itzcarmennn/X-UniTech/others/Supporting Details for Selected Topics/images/image23.png

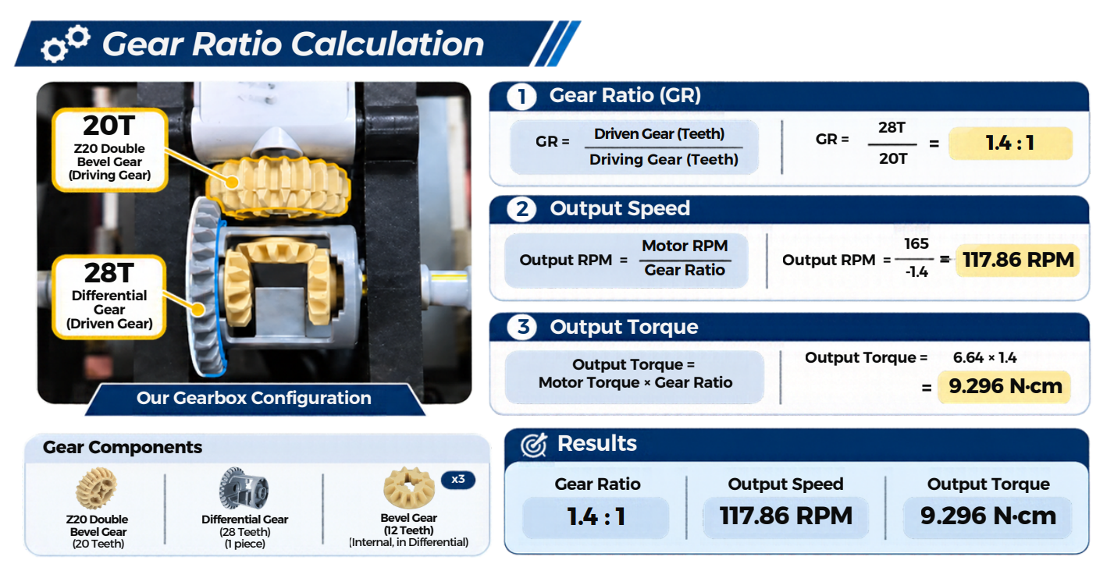
others/Supporting Details for Selected Topics/images/image23.png
