itzcarmennn/X-UniTech/v-photos/C. Third Generation/Left View.png

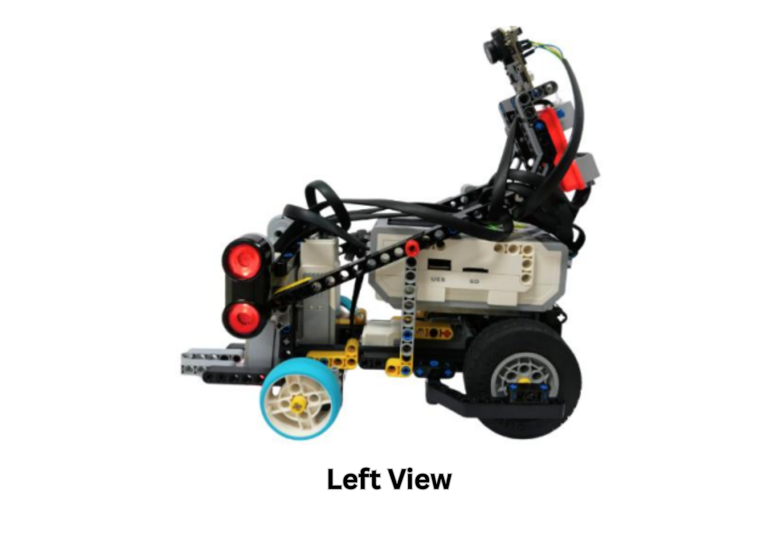
v-photos/C. Third Generation/Left View.png
