itzcarmennn/X-UniTech/README.md

# X-UniTech Team, Malaysia

Welcome to X-UniTech Team Malaysia! 

This repository showcases our final robot design, developed to complete both the **Open Challenge** and **Obstacle Challenge**. For an overview of our development journey from **Generation 1 to Generation 4**, please refer to the [**Robot Development & Iteration Cycle**](https://github.com/itzcarmennn/X-UniTech/blob/4292ab41017db0be74e6131bf3cbaa6cbdb87c5d/others/Robot%20Development%20%26%20Iteration%20Cycle.pdf). For detailed information about our robot's design, engineering decisions, calculations, and testing results, please refer to our **[Engineering Journal](PASTE_YOUR_ENGINEERING_JOURNAL_LINK_HERE)**.

# Table of Contents

# Summary Video
This 6-minute video provides a brief overview of our project and its documentation. We encourage you to watch it for a quick and clear understanding of our work!

# Team Members
We are X-UniTech, a team of two teacher trainees from Malaysia, made up of **Raymond Ting Yih Wei**, the brain behind the code, and **Carmen Heng Jia Min**, the hands behind the robot. Together, we turn ideas into robots!

<p align="center">
Team Photo (Version 2)
</p>

# Robot Overview

<p align="center">

</p>

<table>
  <tr>
    <td align="center"><strong>Top View</strong><br>Top View</td>
    <td align="center"><strong>Front View</strong><br>Front View</td>
    <td align="center"><strong>Left View</strong><br>Left View</td>
  </tr>
  <tr>
    <td align="center"><strong>Bottom View</strong><br>Bottom View</td>
    <td align="center"><strong>Back View</strong><br>Back View</td>
    <td align="center"><strong>Right View</strong><br>Right View</td>
  </tr>
</table>

# Performance Video 

<table>
  <tr>
    <td align="center" width="50%">
      <strong>Open Challenge</strong><br><br>
      Open Challenge<br><br>
      <a href="https://youtu.be/6Eh0cw0jpJg"><strong>▶ Watch Open Challenge Video</strong></a>
    </td>
    <td align="center" width="50%">
      <strong>Obstacle Challenge</strong><br><br>
      Obstacle Challenge<br><br>
      <a href="https://youtu.be/F9Ot-lOl4QI"><strong>▶ Watch Obstacle Challenge Video</strong></a>
    </td>
  </tr>
</table>

If you are interested, explore the previous robot generations (Generation 1–3) in the [**V-Photos Folder**](https://github.com/itzcarmennn/X-UniTech/tree/59bc95add0fecbfca5860f1d18f3c837b4af057b/v-photos).

# 1.0 Mobility and Mechanical Design

## 1.1 Mechanical Structure
<p align="center">
  Robot Photo (Fourth Generation)
</p>

**Robot Dimensions:** Our robot dimensions (**250 mm × 120 mm × 295 mm**) were selected to maximize camera height while maintaining a compact and mechanically stable structure that accommodates all components. 

**Robot Building Process:** Follow our step-by-step building tutorial to learn how to assemble the robot in the [Video Building Process](https://youtu.be/vY-6_uyMKQI?si=AjLbu2vJUjDL66he).

**Robot Chassis:** We initially used a LEGO-built chassis in Generation 1-3 but later switched to a custom 3D-printed chassis to reduce the complexity of multiple LEGO connections and create a more compact, stable structure.

<table>
  <tr>
    <td align="center" width="50%">
      <strong>Previous LEGO Chassis</strong>
    </td>
    <td align="center" width="50%">
      <strong>Recent 3D-Printed Chassis</strong>
    </td>
  </tr>
  <tr>
    <td align="center">
      Previous LEGO Chassis
    </td>
    <td align="center">
      Recent 3D-Printed Chassis
    </td>
  </tr>
</table>

[Click for Robot Chassis CAD and Camera Mounting in STL File](https://github.com/itzcarmennn/X-UniTech/tree/59bc95add0fecbfca5860f1d18f3c837b4af057b/models/Materials%20of%20Computer-Aided%20Design%20(CAD)%20%5BFourth%20Generati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)

**Motor:** We selected the **EV3 Medium Motor (45503)** for its higher rotational speed and compact size. During the Open Challenge, the drive motor operates at 100% speed. During the Obstacle Challenge, the drive motor operates at 65% speed, while the steering motor operates at 70% speed to maintain stability and ensure reliable obstacle navigation. [**Purchase Link**](https://www.brickowl.com/catalog/lego-mindstorms-ev3-medium-motor-99455)

<p align="center">

</p>

## 1.2 Drive System

<table>
  <tr>
    <td width="30%" align="center" valign="middle">
      Gearbox Configuration
    </td>
    <td width="70%" align="justify" valign="middle">
      We selected the <strong>EV3 Medium Servo Motor (45503)</strong> with a 20T driving gear and 28T differential-driven gear, achieving a 1.4:1 gear reduction ratio. The wheel assembly uses <strong>LEGO Parts 32019</strong> and <strong>86652</strong> to complete the drive mechanism. This configuration reduces the output speed while increasing the available torque to support robot movement.
      <br><br>
      Here's how we calculate it:
    </td>
  </tr>
</table>

<p align="center">

</p>

This combination also provides an ideal force and thrust-to-weight ratio. Here’s how we calculate it. 

<p align="center">

</p>

[Click for detailed information on Drive System Choice](https://drive.google.com/file/d/1EcJO7IQbdKK3gPobmQDVCEyetCO6iOfM/view?usp=sharing)

## 1.3 Steering System

<p align="center">
Steering Structure
</p>

Our steering system combines a **LEGO Pin Crank (33299)**, which serves as the transmission component, with custom-designed 3D-printed parts. LEGO axles and connectors are used to connect the components and complete the steering mechanism.

[Here’s more about Steering Component CADs in STL File](https://github.com/itzcarmennn/X-UniTech/tree/59bc95add0fecbfca5860f1d18f3c837b4af057b/models/Materials%20of%20Computer-Aided%20Design%20(CAD)%20%5BFourth%20Generati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)

<p align="center">

</p>

**Ackermann Steering:** We chose Ackermann steering because it allows the inner wheel to turn more than the outer wheel, resulting in smoother turns. The following calculation shows the outer wheel angle when the inner wheel angle is 35° during a left turn.

<p align="center">

</p>

**Iterations & Trade-off:** In Generation 2, we tested a **gear-reduced steering system** but found it responded more slowly than direct steering. Therefore, we decided to retain the **direct steering** mechanism for more responsive turning. 

<p align="center">
Iterations Trade-off
</p>

**Steering System Trade-off**
<p align="center">

</p>

• The Ackermann steering system was selected because it provides better turning performance, reduces tyre scrubbing and improves manoeuvrability. 
<p align="center">

</p>

[Click for detailed information on Steering System Choice](https://drive.google.com/file/d/1WwsIxELfLkICFE4XAowNIsLzPJPw8FXX/view?usp=sharing)

# 2.0 Power and Sensor Architecture

**Power System Layout:** A 9V battery supply powers the **EV3 Intelligent Brick** as the **“brain”** of our robot, which manages two motors and four sensor connections, including two Ultrasonic Sensors through the MUX.
<p align="center">
Power System Layout
</p>

## 2.1 Power Budget

The maximum current value is used, while both EV3 Medium Motors are calculated using their stalled current of 800 mA each. 
<p align="center">

</p>

The total power consumption is: 0.015 + 0.075 + 0.200 + 0.175 + 14.400 + 0.700 = <strong><ins>15.565 W</ins></strong>.  
Here’s how to calculate the Battery Runtime Calculation for Max Load (15.565W):

<div align="center">

<table>
  <tr>
    <td width="50%" align="center" valign="middle">
      <table>
        <tr style="background-color: #DCEAF7;">
          <th align="center">Battery Parameter</th>
          <th align="center">Value</th>
        </tr>
        <tr>
          <td align="center"><strong>Nominal Voltage</strong></td>
          <td align="center">9V</td>
        </tr>
        <tr>
          <td align="center"><strong>Battery Capacity</strong></td>
          <td align="center">2333mAh</td>
        </tr>
        <tr>
          <td align="center"><strong>Total Energy</strong></td>
          <td align="center">21Wh</td>
        </tr>
      </table>
    </td>
    <td width="50%" align="center" valign="middle">
      Battery Runtime Calculation
    </td>
  </tr>
</table>

</div>
