itzcarmennn/X-UniTech/schemes/ObstacleChallenge_SchematicDiagram.pdf

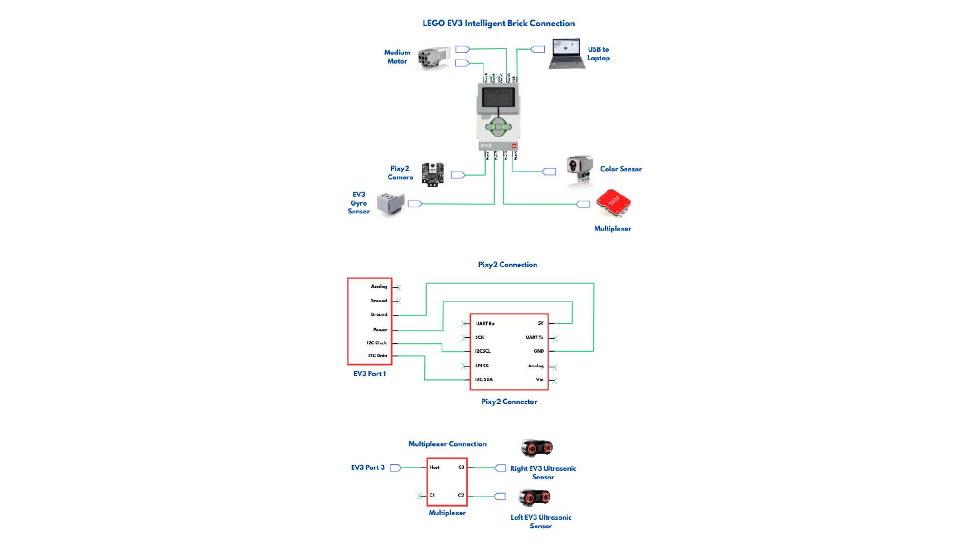
[picture p149: page 1]
