itzcarmennn/X-UniTech/schemes/OpenChallenge_SchematicDiagram.pdf

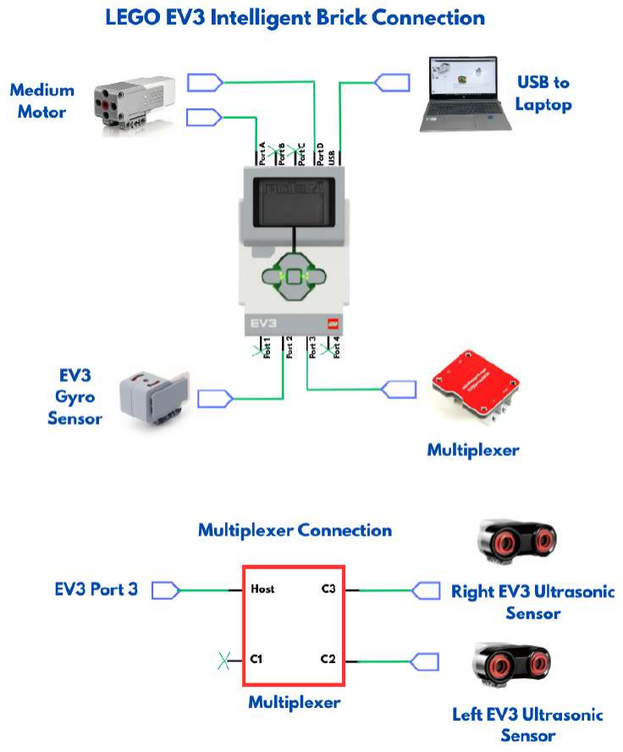
[picture p150: page 1]
