itzcarmennn/X-UniTech/src/B. Open Challenge Flow Chart (Second Generation_03102026).pdf

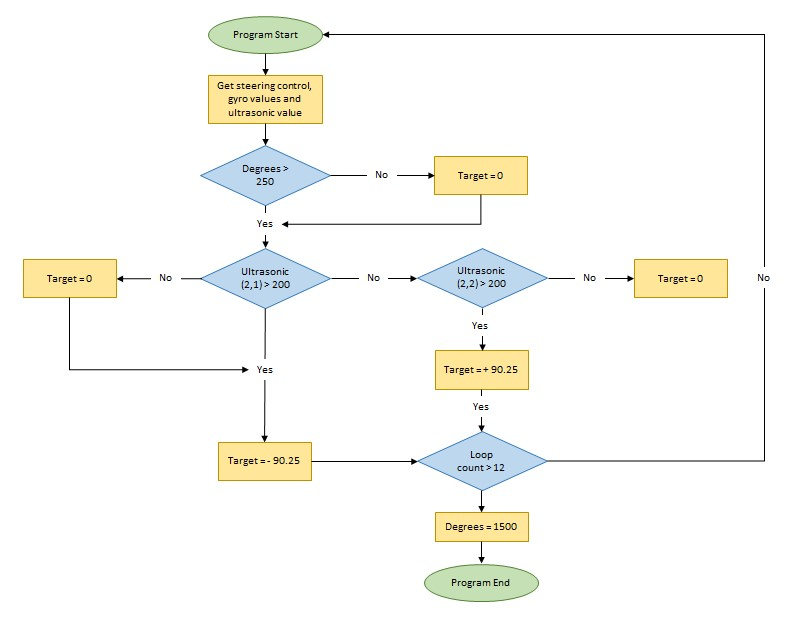
[picture p151: figure]
