itzcarmennn/X-UniTech/src/A. Obstacle Challenge Flow Chart (First Generation_16092026).pdf

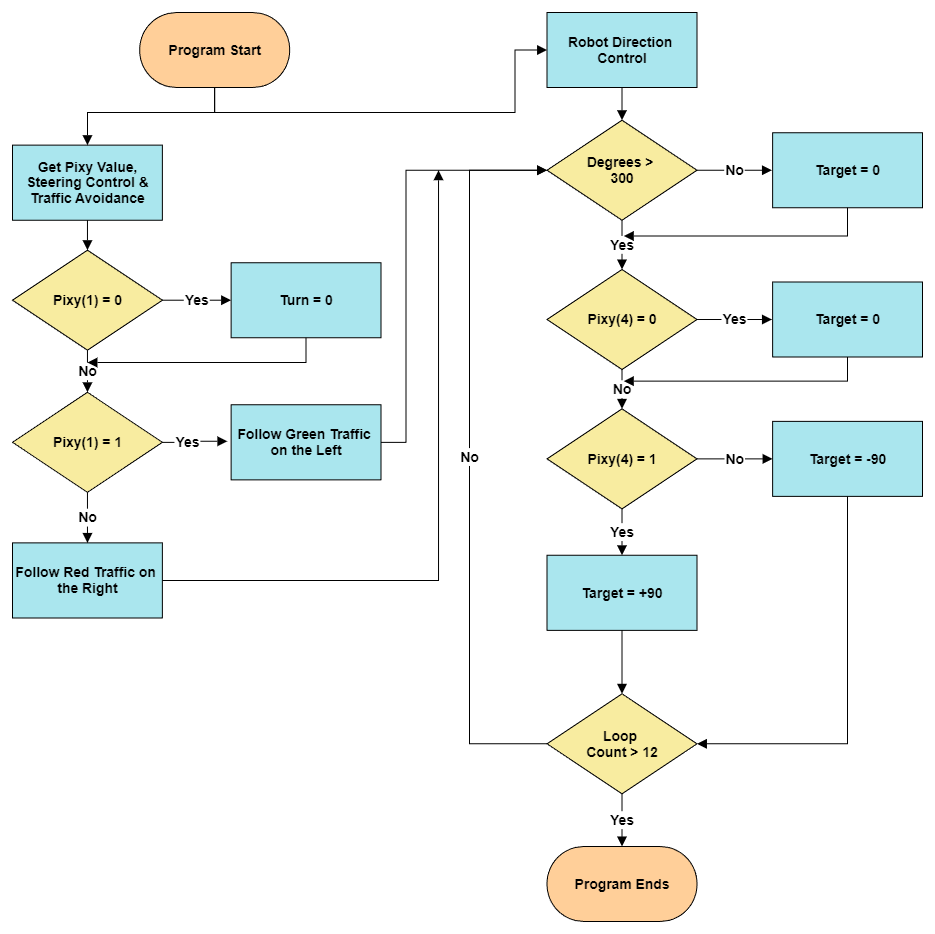
[picture p152: figure]
