itzcarmennn/X-UniTech/src/A. Open Challenge Flow Chart (First Generation_16092026).pdf

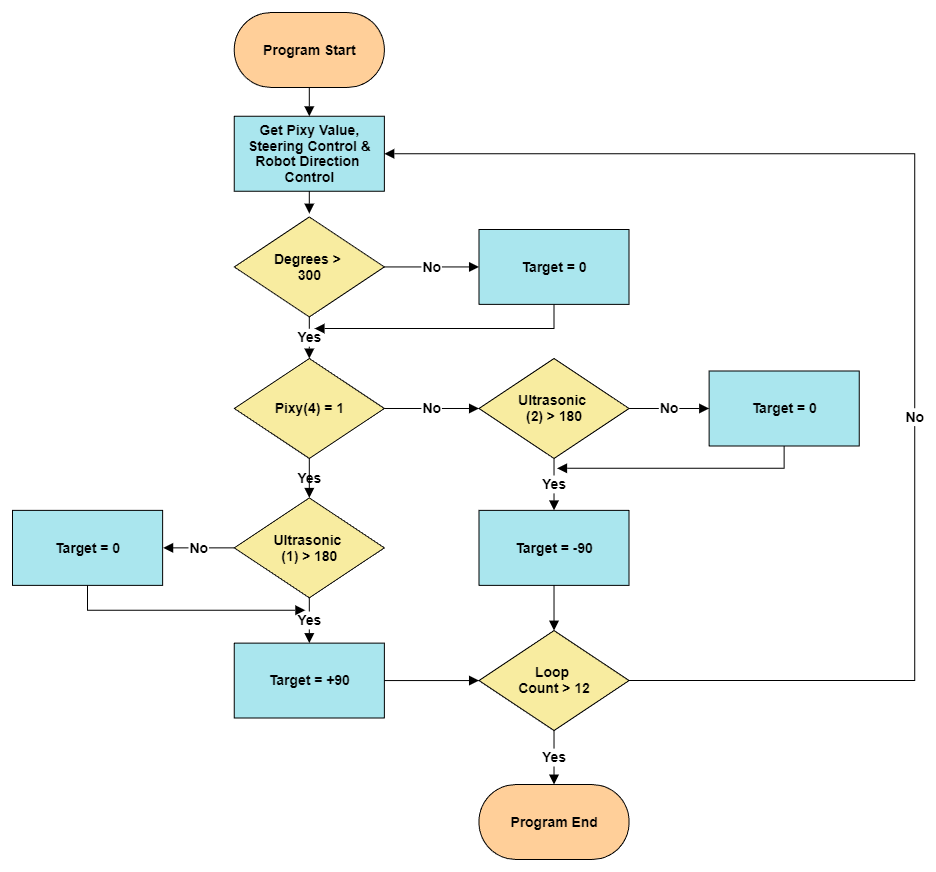
[picture p153: page 1]
