itzcarmennn/X-UniTech/others/Supporting Details for Selected Topics/images/image19.jpg

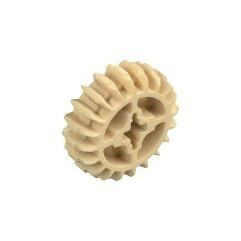
others/Supporting Details for Selected Topics/images/image19.jpg
