itzcarmennn/X-UniTech/others/Supporting Details for Selected Topics/images/image20.png

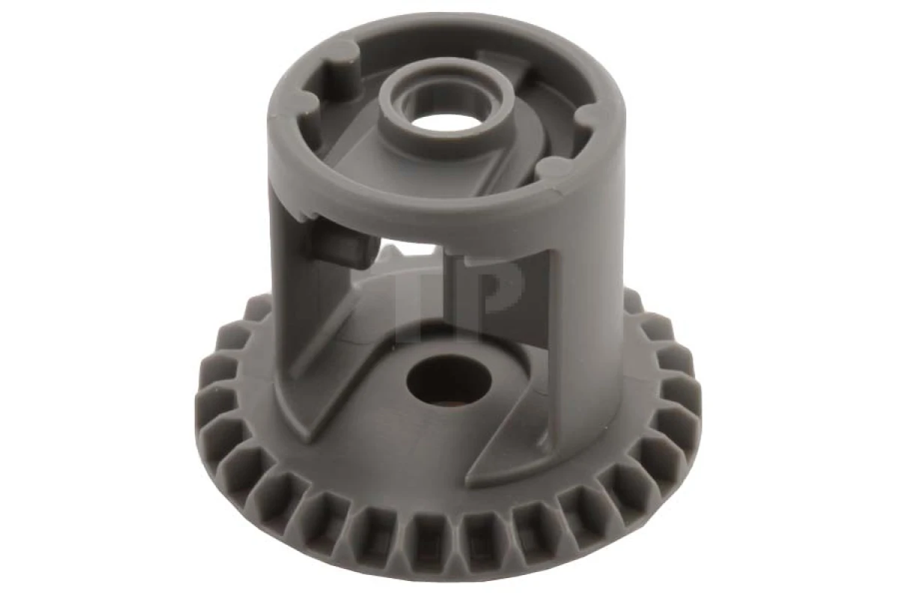
others/Supporting Details for Selected Topics/images/image20.png
