itzcarmennn/X-UniTech/others/Supporting Details for Selected Topics/images/image21.jpg

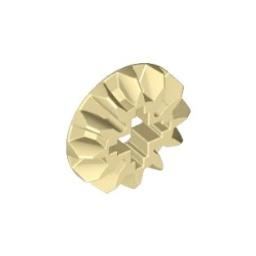
others/Supporting Details for Selected Topics/images/image21.jpg
