itzcarmennn/X-UniTech/others/Supporting Details for Selected Topics/images/image22.png

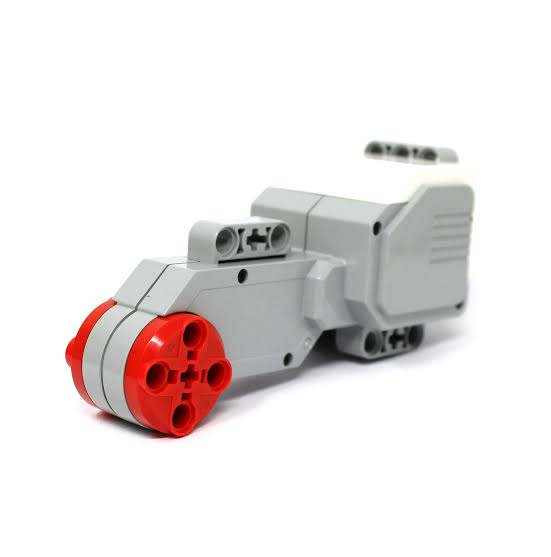
others/Supporting Details for Selected Topics/images/image22.png
