itzcarmennn/X-UniTech/others/Supporting Details for Selected Topics/images/image24.png

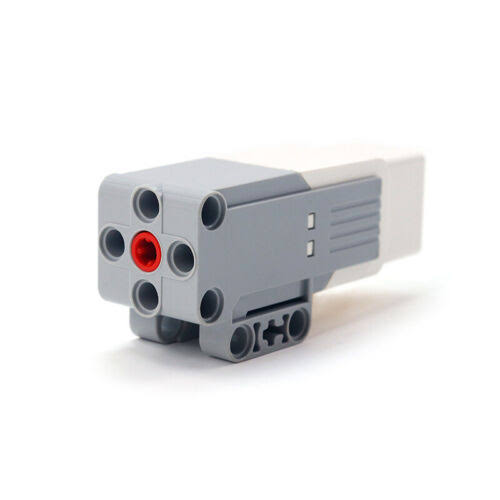
others/Supporting Details for Selected Topics/images/image24.png
