itzcarmennn/X-UniTech/t-photos/X-UniTech_Team Photo 1.jpg

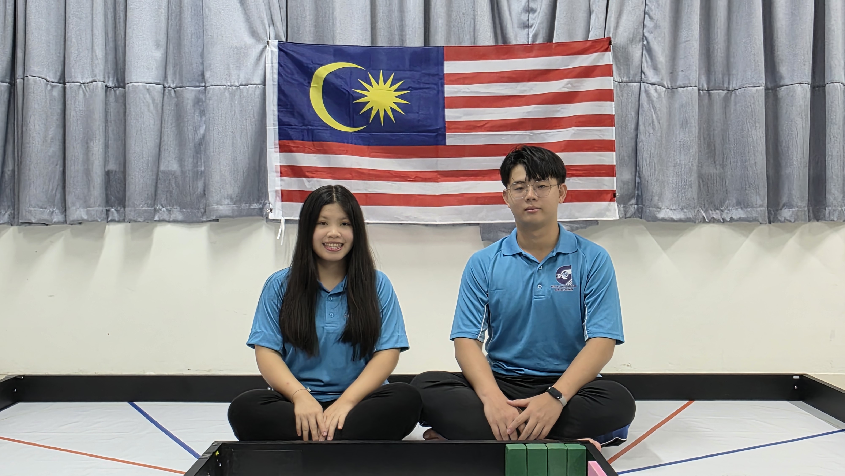
t-photos/X-UniTech_Team Photo 1.jpg
