itzcarmennn/X-UniTech/t-photos/X-UniTech_Team Photo 2.jpg

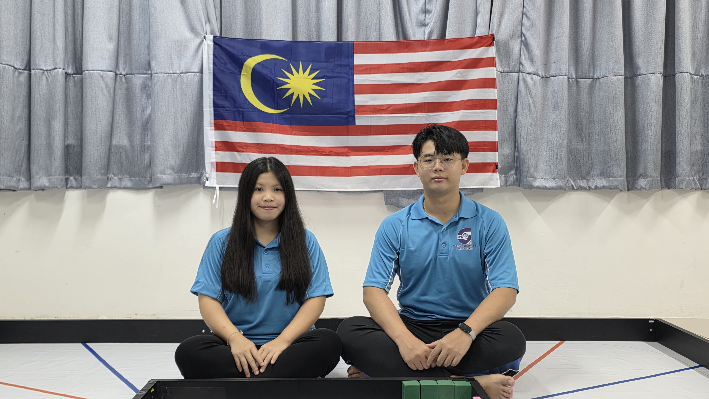
t-photos/X-UniTech_Team Photo 2.jpg
