itzcarmennn/X-UniTech/t-photos/X-UniTech_Team Photo 3.jpeg

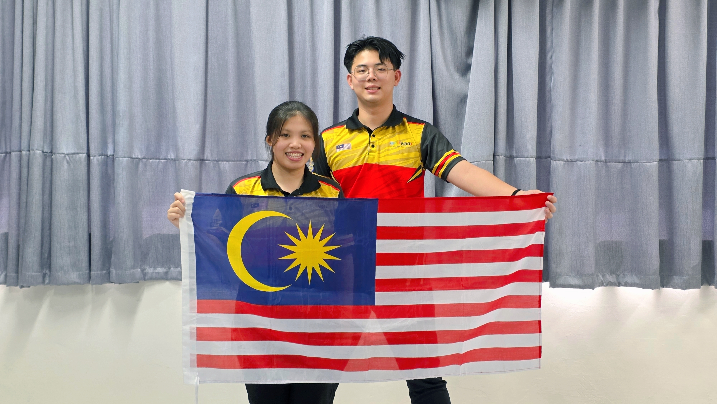
t-photos/X-UniTech_Team Photo 3.jpeg
