itzcarmennn/X-UniTech/v-photos/A. First Generation/Bottom View.png

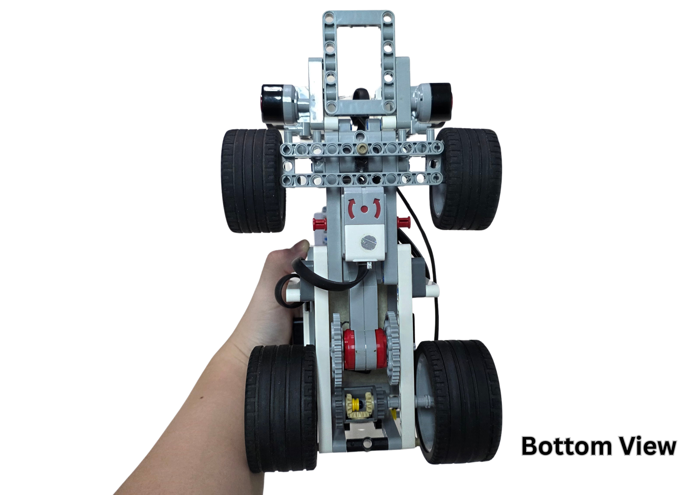
v-photos/A. First Generation/Bottom View.png
