itzcarmennn/X-UniTech/v-photos/A. First Generation/Front View.png

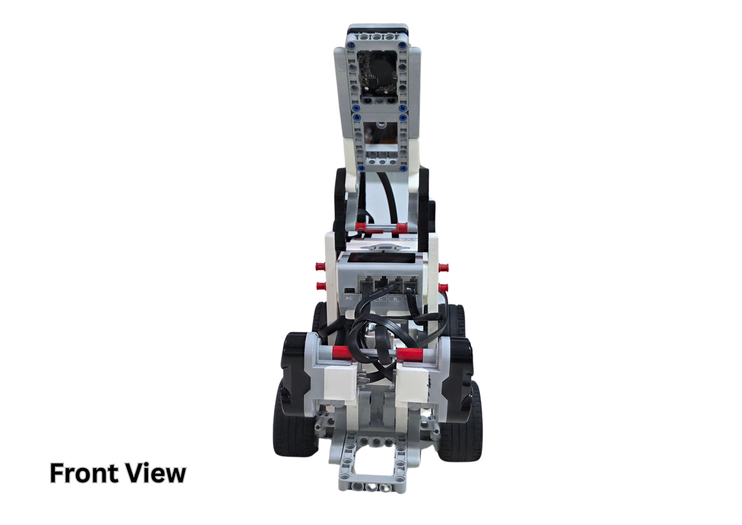
v-photos/A. First Generation/Front View.png
