itzcarmennn/X-UniTech/v-photos/A. First Generation/Top View.png

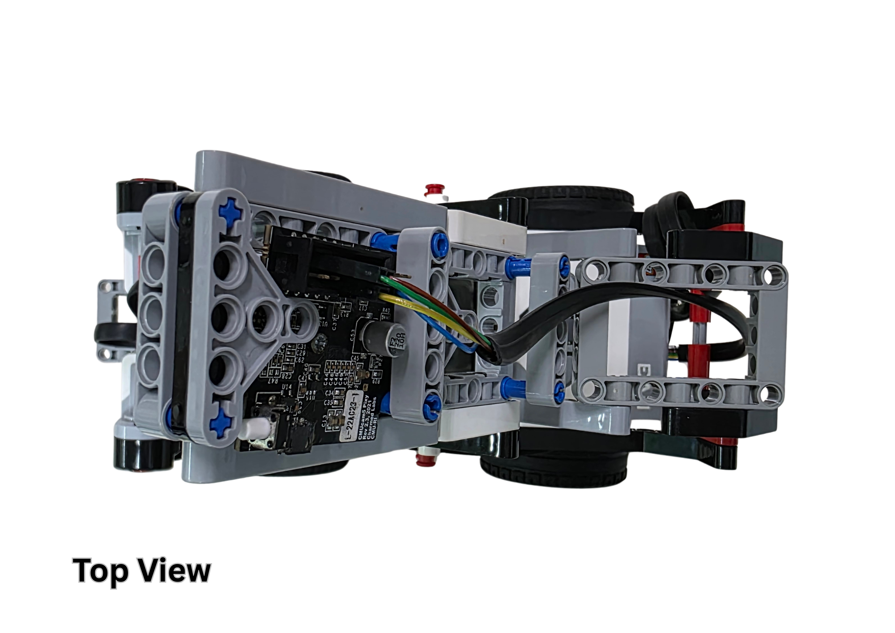
v-photos/A. First Generation/Top View.png
