itzcarmennn/X-UniTech/v-photos/B. Second Generation/Bottom View.png

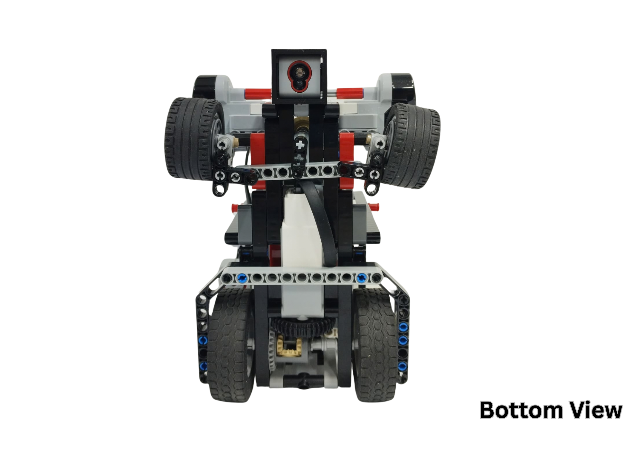
v-photos/B. Second Generation/Bottom View.png
