itzcarmennn/X-UniTech/v-photos/B. Second Generation/Left View.png

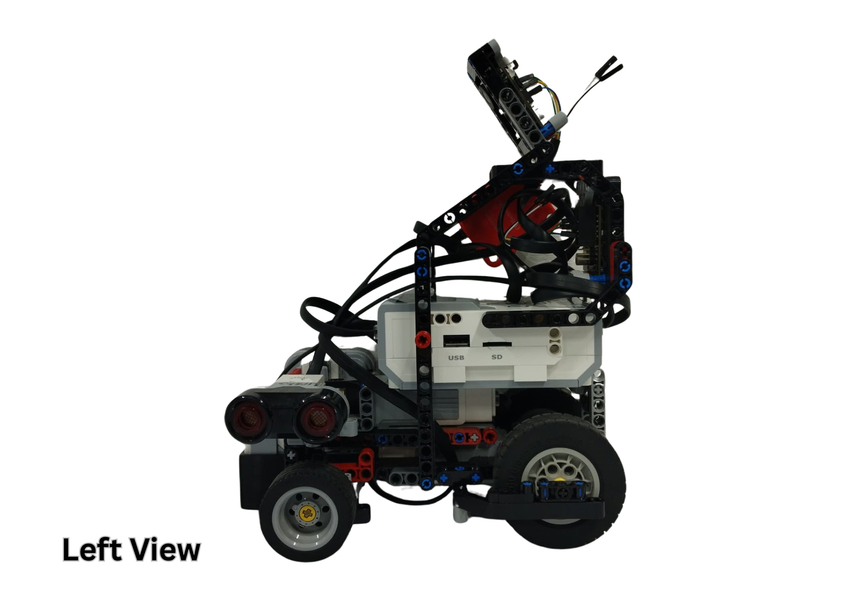
v-photos/B. Second Generation/Left View.png
