itzcarmennn/X-UniTech/v-photos/B. Second Generation/Right View.png

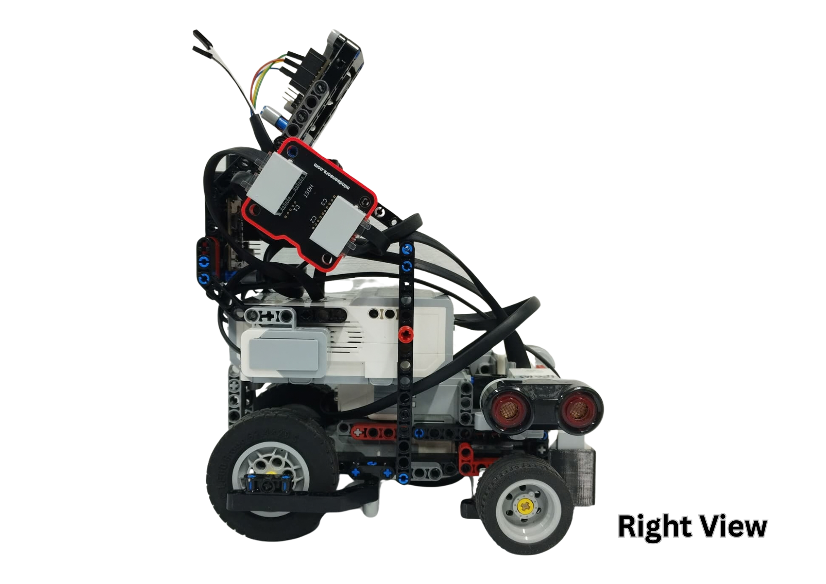
v-photos/B. Second Generation/Right View.png
