itzcarmennn/X-UniTech/v-photos/D. Fourth Generation/Back View.png

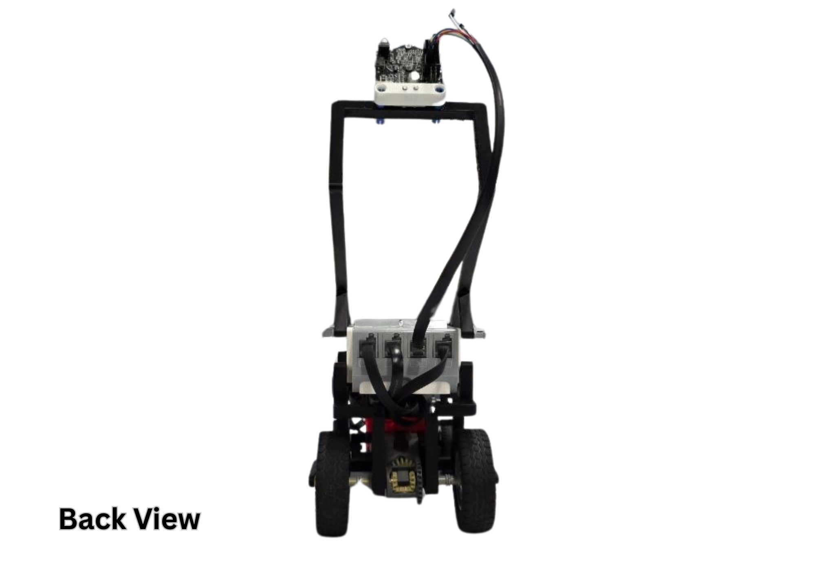
v-photos/D. Fourth Generation/Back View.png
