itzcarmennn/X-UniTech/v-photos/D. Fourth Generation/Left View.png

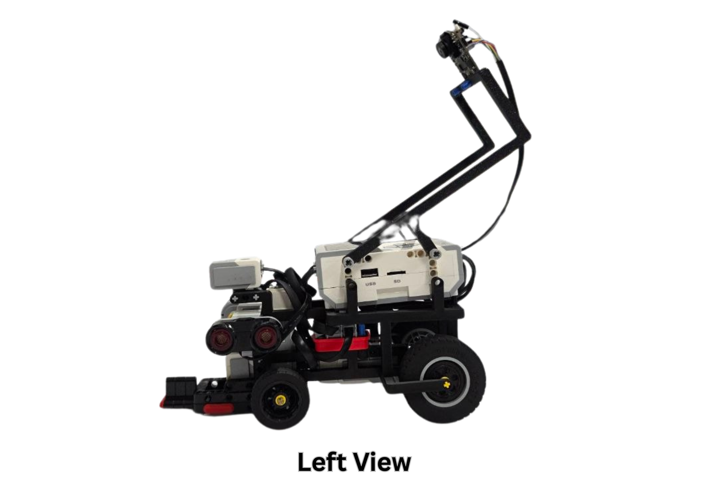
v-photos/D. Fourth Generation/Left View.png
