itzcarmennn/X-UniTech/v-photos/D. Fourth Generation/Top View.png

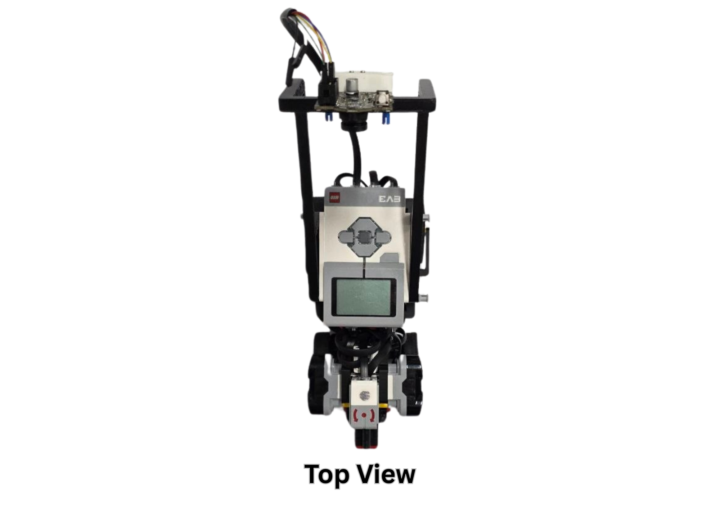
v-photos/D. Fourth Generation/Top View.png
