itzcarmennn/X-UniTech/v-photos/First Generation/Right View.png

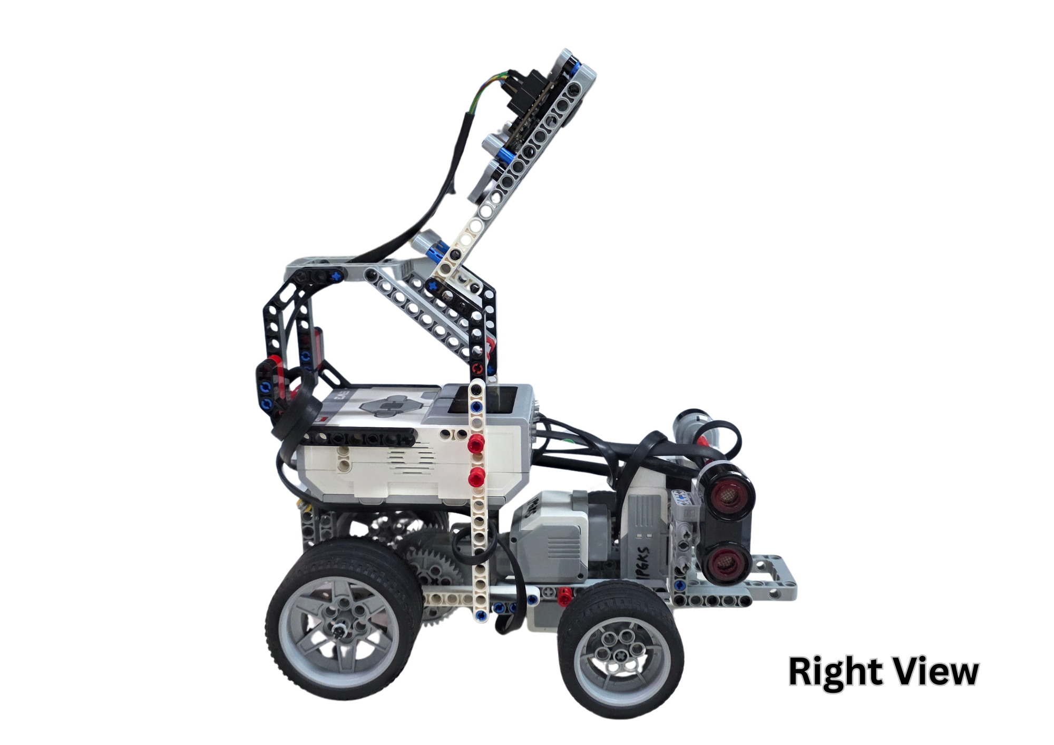
v-photos/First Generation/Right View.png
