itzcarmennn/X-UniTech/v-photos/Fourth Generation/Right View.png

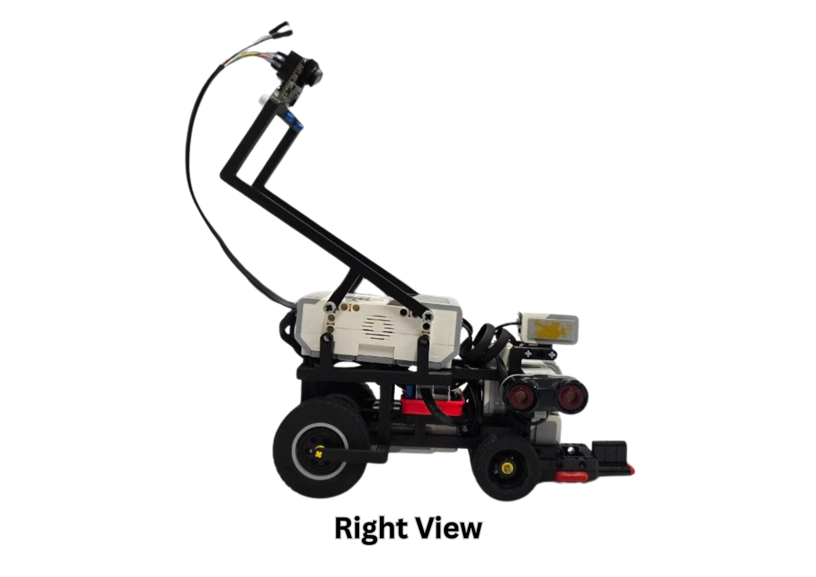
v-photos/Fourth Generation/Right View.png
