itzcarmennn/X-UniTech/v-photos/Third Generation/Right View.png

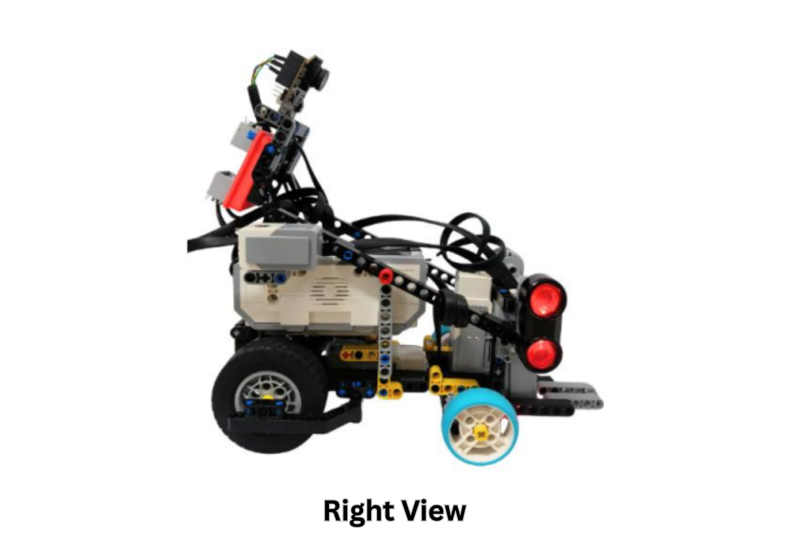
v-photos/Third Generation/Right View.png
