itzcarmennn/X-UniTech/models/Materials of Computer-Aided Design (CAD) [Fourth Generation]/Camera Mounting Bracket.stl

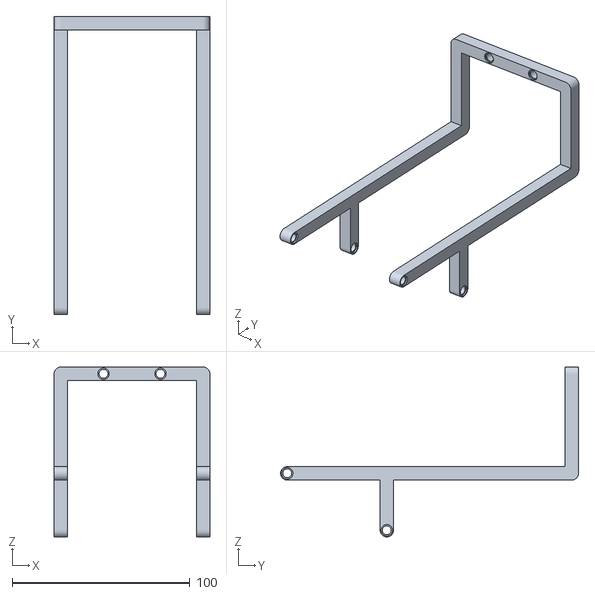
[picture p174: CAD file, 2026-11-12]
models/Materials of Computer-Aided Design (CAD) [Fourth Generation]/Camera Mounting Bracket.stl
87.6 x 167.6 x 95.6
