itzcarmennn/X-UniTech/models/Materials of Computer-Aided Design (CAD) [Fourth Generation]/Steering Parts/Steering Lingkage Half 7CM.stl

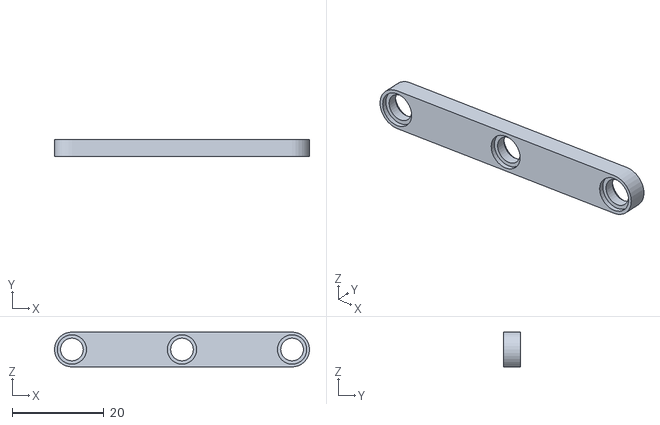
[picture p175: CAD file, 2026-11-12]
models/Materials of Computer-Aided Design (CAD) [Fourth Generation]/Steering Parts/Steering Lingkage Half 7CM.stl
55.6 x 3.60 x 7.60
