itzcarmennn/X-UniTech/models/Materials of Computer-Aided Design (CAD) [Fourth Generation]/Custom Chassis （Right Size）.stl

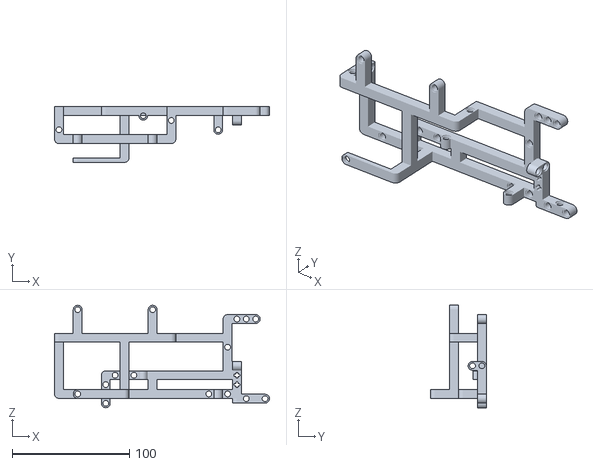
[picture p176: CAD file, 2026-11-12]
models/Materials of Computer-Aided Design (CAD) [Fourth Generation]/Custom Chassis （Right Size）.stl
183.6 x 47.6 x 87.6
