itzcarmennn/X-UniTech/models/Materials of Computer-Aided Design (CAD) [Fourth Generation]/Steering Parts/Steering Tie Rod （Print for Both Size）.stl

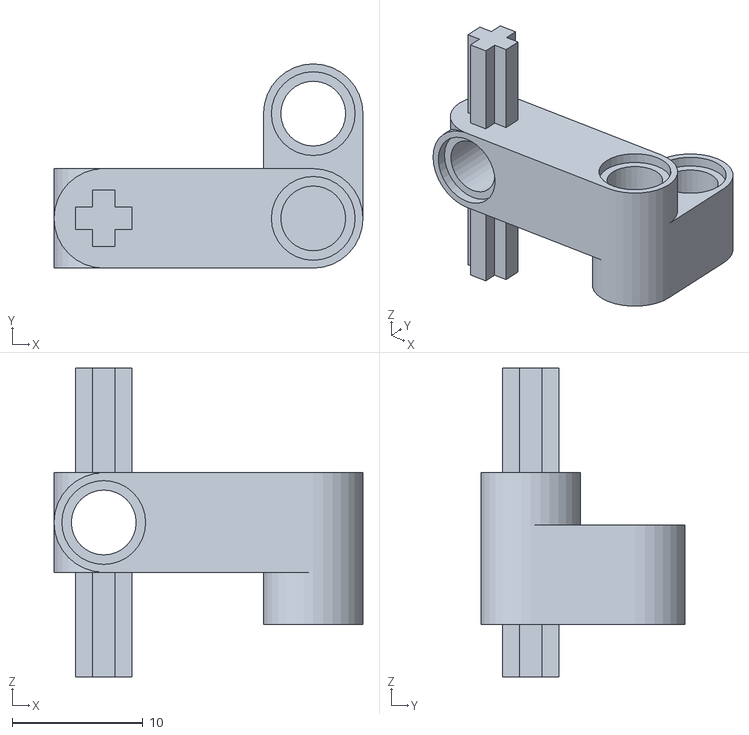
[picture p177: CAD file, 2026-11-12]
models/Materials of Computer-Aided Design (CAD) [Fourth Generation]/Steering Parts/Steering Tie Rod （Print for Both Size）.stl
23.6 x 15.6 x 23.6
