itzcarmennn/X-UniTech/models/Materials of Computer-Aided Design (CAD) [Fourth Generation]/Custom Chassis （Left Size）.stl

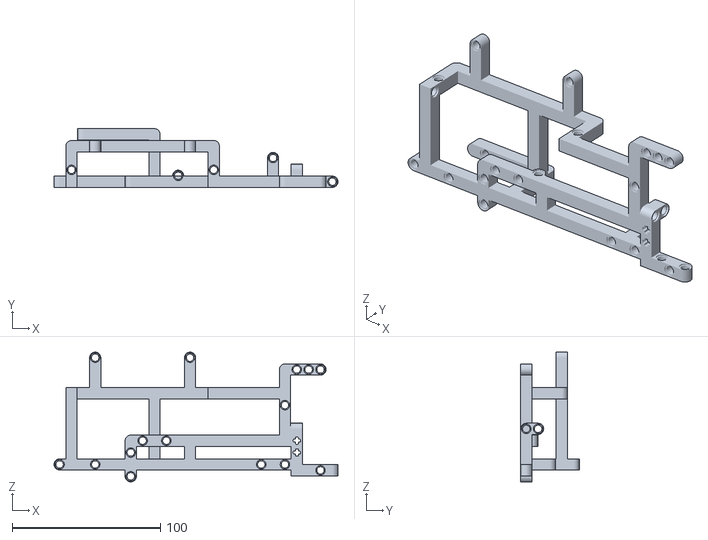
[picture p178: CAD file, 2026-11-12]
models/Materials of Computer-Aided Design (CAD) [Fourth Generation]/Custom Chassis （Left Size）.stl
191.6 x 39.6 x 87.6
