itzcarmennn/X-UniTech/models/Materials of Computer-Aided Design (CAD) [Fourth Generation]/Steering Parts/Steering Lingkage 9CM.stl

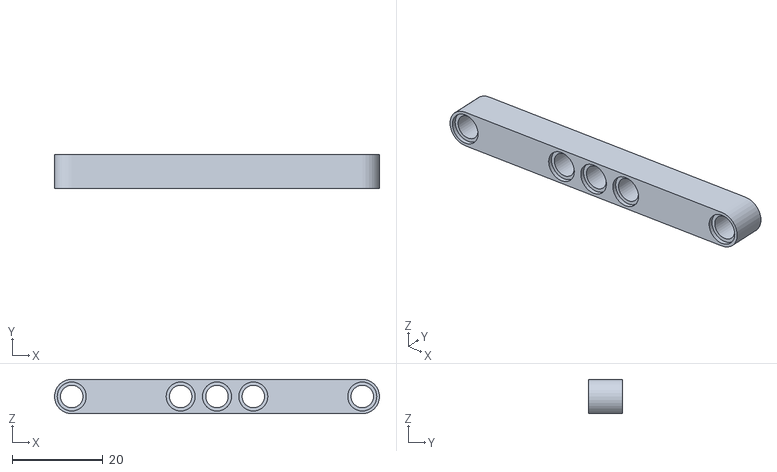
[picture p179: CAD file, 2026-11-12]
models/Materials of Computer-Aided Design (CAD) [Fourth Generation]/Steering Parts/Steering Lingkage 9CM.stl
71.6 x 7.60 x 7.60
