itzcarmennn/X-UniTech/schemes/Wiring Diagrams (Final Version).pdf

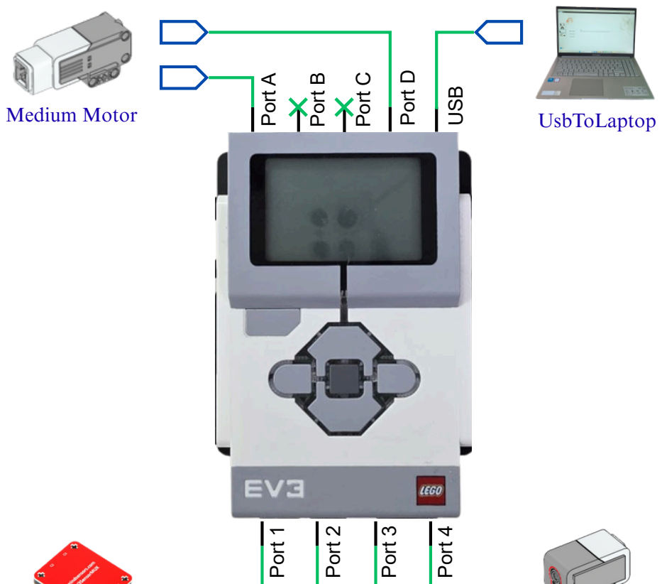
[picture p180: figure]
ort B; ort C; ort A; ort D; ort 1; ort 2; ort 3; ort 4; Medium Motor; UsbToLaptop

5V
UART Tx
GND
Analog
Vin

UART Rx
SCK
I2C SCL
SPI SS
I2C SDA

## LEGO EV3 Intelligent Brick Connection

EV3 Gryo Sensor | Pixy2Camera

Color Sensor EV3 Multiplexer

## Pixy2 Connection

Analog
Ground
Ground
Power
I2C Clock
I2C Data
EV3 Port 1 | Pixy 2 Connector
| Multiplexer Connection

C3

C2

Host

C1

EV3 Port 3

Left EV3
Ultrasonic Sensor
Multiplexer | Right EV3
| Ultrasonic Sensor
