itzcarmennn/X-UniTech/src/D. Open Challenge Flow Chart (Fourth Generation_06112026).pdf

## State A - Initial Navigation

## Open Challenge State Machine with Composite State

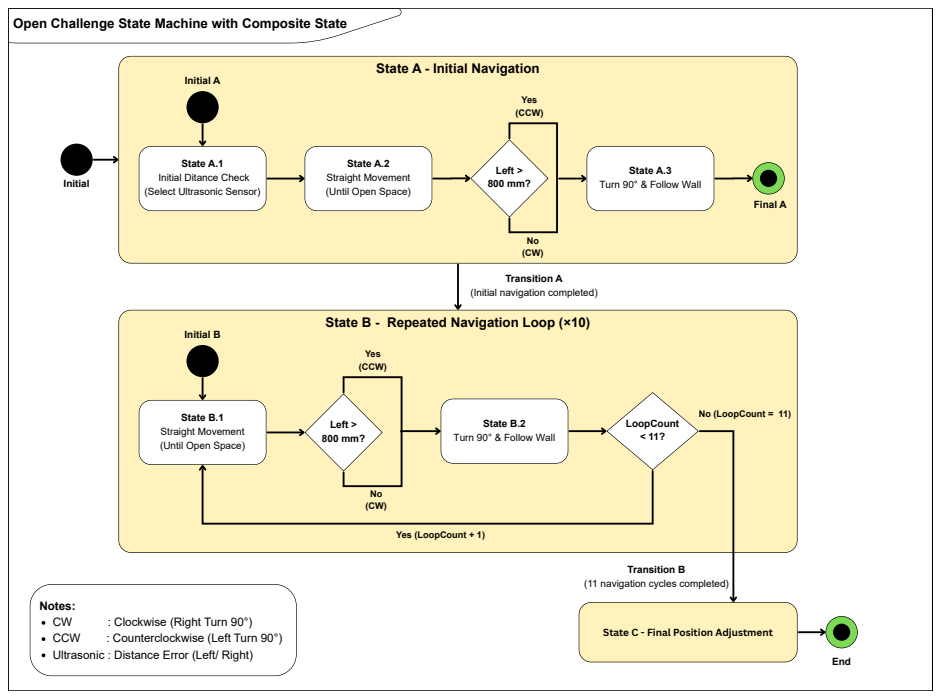
[picture p187: page 1]
Left > 800 mm?; LoopCount < 11?; : Clockwise (Right Turn 90°); CCW; : Counterclockwise (Left Turn 90°); Initial; Initial A; Yes (CCW); Final A; Initial B; End; Transition A; Transition B; Yes (LoopCount + 1); No (LoopCount = 11)

State A.1
Initial Ditance Check
(Select Ultrasonic Sensor)

State A.2
Straight Movement
(Until Open Space)

State A.3
Turn 90° & Follow Wall

(Initial navigation completed)

State B - Repeated Navigation Loop (×10)

State B.1

State B.2

(11 navigation cycles completed)

Notes:
Ultrasonic : Distance Error (Left/ Right)

State C - Final Position Adjustment
