itzcarmennn/X-UniTech/src/B. Obstacle Challenge Flow Chart (Second Generation_03102026).pdf

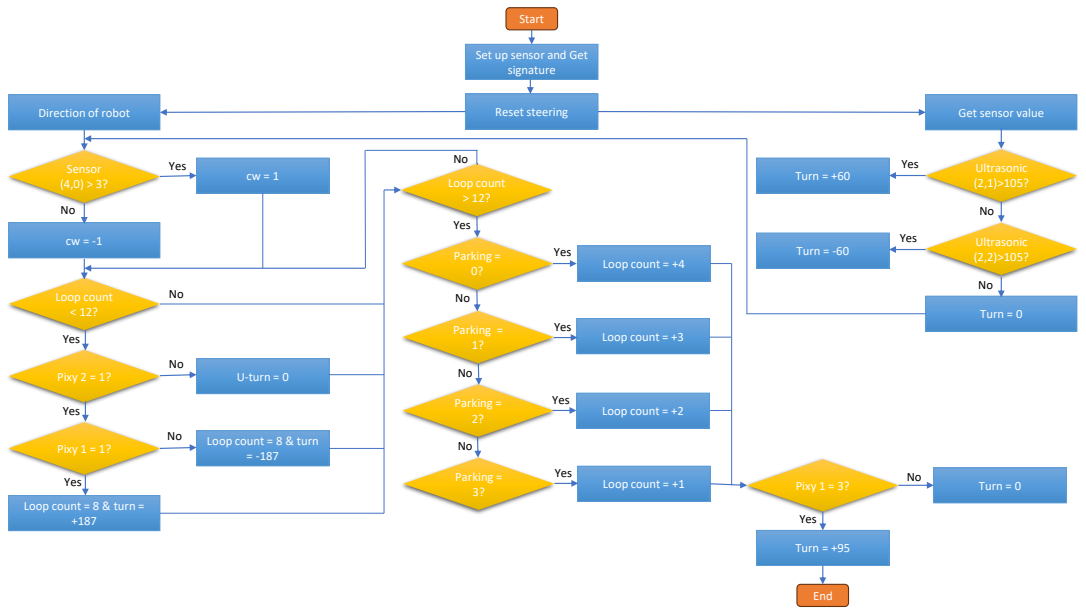
[picture p188: page 1]
Start; Reset steering; Get sensor value; Turn = +60; Turn = 0; Ultrasonic (2,1)>105?; Ultrasonic (2,2)>105? Turn = -60; Sensor (4,0) > 3?; Loop count < 12?; Pixy 2 = 1?; Pixy 1 = 1?; U-turn = 0; Loop count > 12?; Parking = 0?; Parking = 2?; Parking = 1?; Parking =; Pixy 1 = 3?; Loop count = +4; Loop count = +3; Loop count = +2; Loop count = +1; Turn = +95; End; Yes

Set up sensor and Get
signature

Direction of robot

Loop count = 8 & turn

Loop count = 8 & turn =
