itzcarmennn/X-UniTech/src/D. Obstacle Challenge State Machine (Fourth Generation_06112026).pdf

## State A - Initial Navigation

## Obstacle Challenge State Machine with Composite State

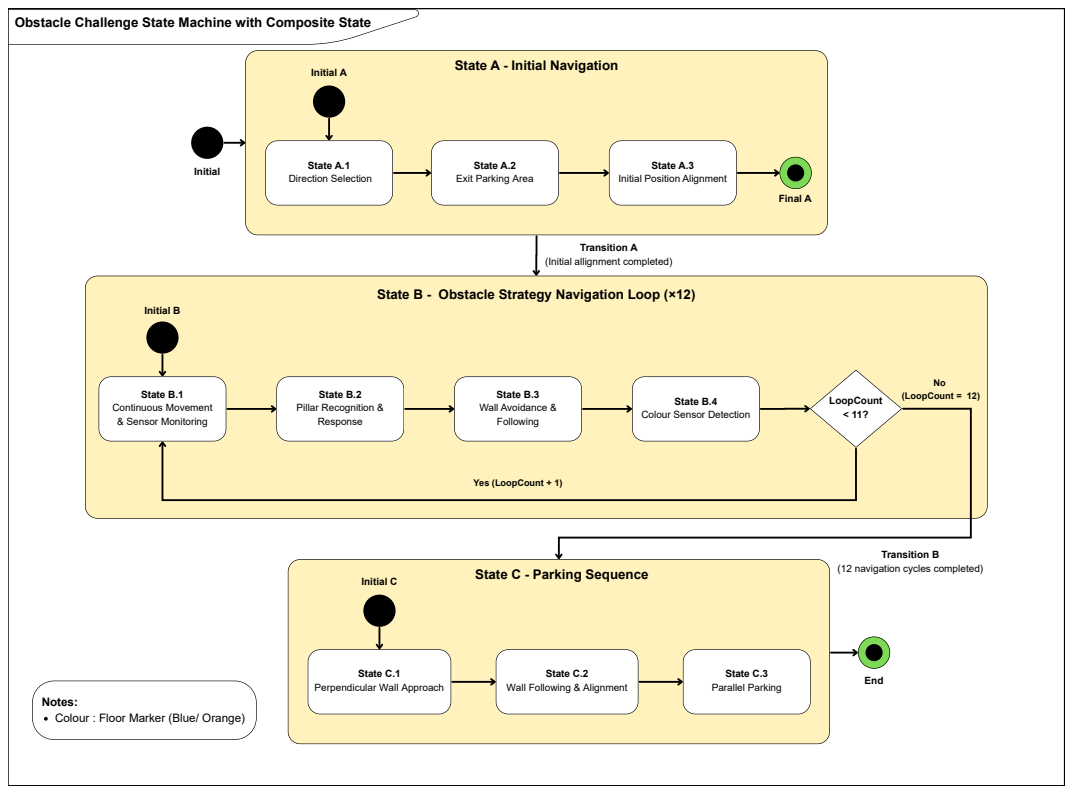
[picture p189: page 1]
State A.1 Direction Selection; Initial; Initial A; Final A; State B.1 Continuous Movement & Sensor Monitoring; Initial B; End; LoopCount; Transition A; Transition B; No (LoopCount = 12); State B.2 Pillar Recognition & Response; State B.3 Wall Avoidance & Following; State B.4; State C.1; State C.2; Initial C; State C.3 Parallel Parking

State A.2
Exit Parking Area

State A.3
Initial Position Alignment

(Initial allignment completed)

State B - Obstacle Strategy Navigation Loop (×12)

Colour Sensor Detection | < 11?

Yes (LoopCount + 1)

(12 navigation cycles completed)

State C - Parking Sequence

Perpendicular Wall Approach

Wall Following & Alignment

Notes:
Colour : Floor Marker (Blue/ Orange)
