itzcarmennn/X-UniTech/(commit log)

2026-09-16 Rename Obstacle Challenge Flow Chart (First Generation_09162026).pdf to Obstacle Challenge Flow Chart (First Generation_16092026).pdf
2026-09-16 Rename Open Challenge Flow Chart (First Generation_09162026).pdf to Open Challenge Flow Chart (First Generation_16092026).pdf
2026-10-03 Rename Obstacle Challenge Flow Chart (First Generation_16092026).pdf to A. Obstacle Challenge Flow Chart (First Generation_16092026).pdf
2026-10-03 Rename Open Challenge Flow Chart (First Generation_16092026).pdf to A. Open Challenge Flow Chart (First Generation_16092026).pdf
2026-10-03 Rename Obstacle Challenge Flow Chart (Second Generation_03102026).pdf to B. Obstacle Challenge Flow Chart (Second Generation_03102026).pdf
2026-10-03 Rename Open Challenge Flow Chart (Second Generation_03102026).pdf to B. Open Challenge Flow Chart (Second Generation_03102026).pdf
2026-11-07 Rename D. Obstacle Challenge Flow Chart (Fourth Generation_06112026).pdf to D. Obstacle Challenge State Machine (Fourth Generation_06112026).pdf
2026-11-07 Rename D. Open Challenge Flow Chart (Fourth Generation_06112026).pdf to D. Open Challenge State Machine (Fourth Generation_06112026).pdf
